George-SK/Smart-Street-Lamp---LORa-Terminal/_document/BaldurMind各频段节点时间同步默认组播地址.docx

# BaldurMind

# 各频段节点时间同步默认组播地址

频段 | 地址 | NwkSKeys | AppSKeys
CN470 | FFFFFFFF | 0691c28cd2861ecbb8b1f53366311530 | 8aed39c164a698924727ced78ee4ead0
EU863 | FFFFFFFE | 0691c28cd2861ecbb8b1f53366311531 | 8aed39c164a698924727ced78ee4ead1
AU915 | FFFFFFFD | 0691c28cd2861ecbb8b1f53366311532 | 8aed39c164a698924727ced78ee4ead2
US902 | FFFFFFFC | 0691c28cd2861ecbb8b1f53366311533 | 8aed39c164a698924727ced78ee4ead3
AS923 | FFFFFFFB | 0691c28cd2861ecbb8b1f53366311534 | 8aed39c164a698924727ced78ee4ead4
