George-SK/Smart-Street-Lamp---LORa-Terminal/hardware/AC灯控板原理图.pdf

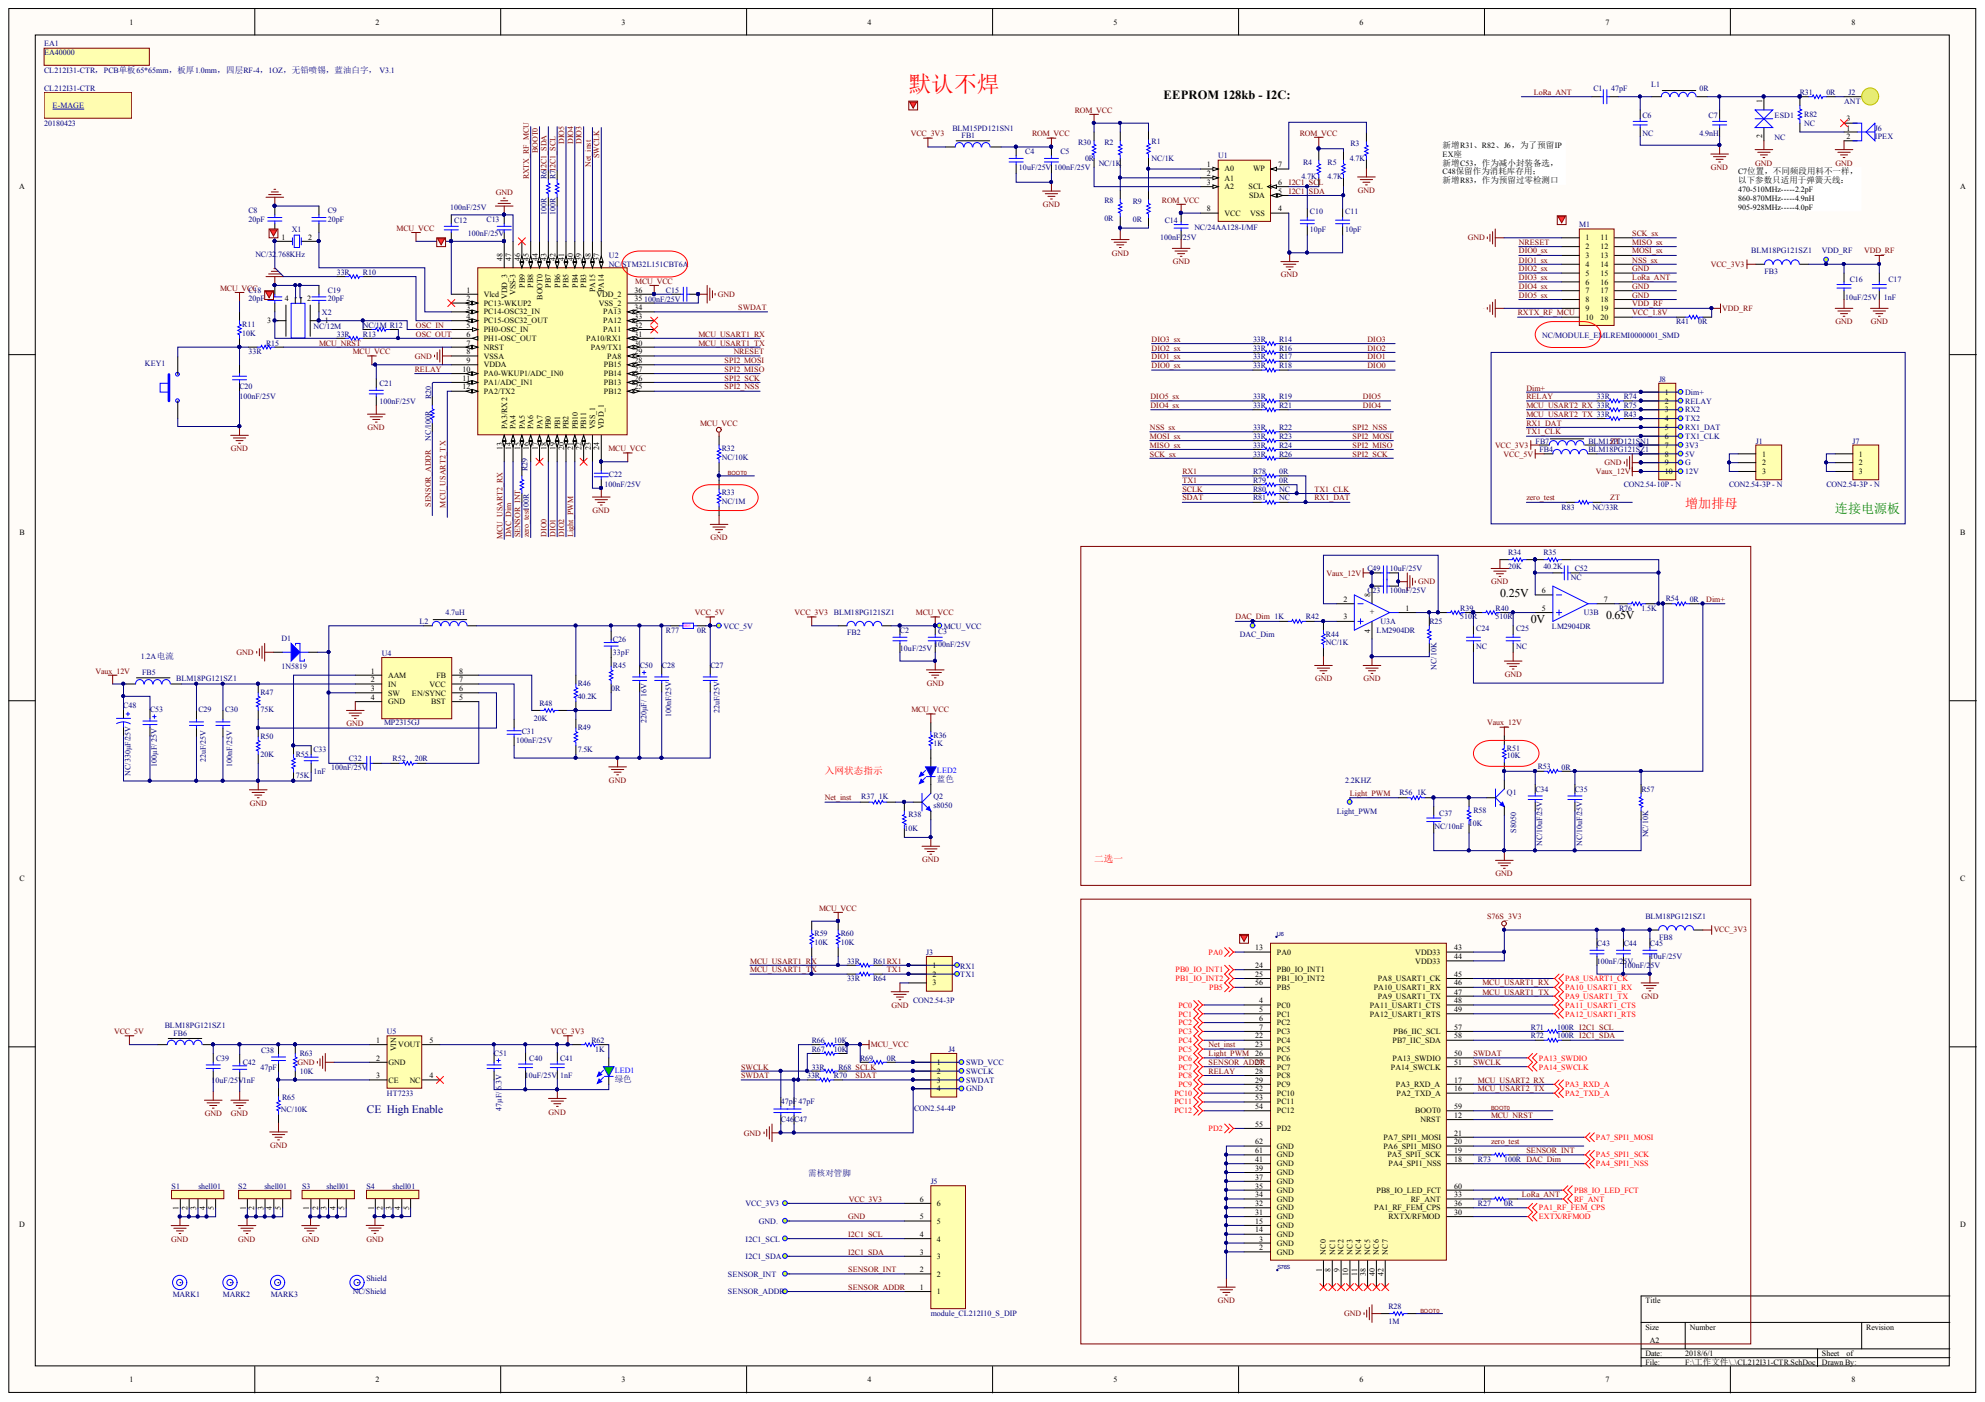
[picture p17: page 1]

CL212I31-CTR，PCB单板65*65mm，板厚1.0mm，四层RF-4，1OZ，无铅喷锡，蓝油白字， V3.1
