George-SK/Smart-Street-Lamp---LORa-Terminal/hardware/AC灯控电源板原理图.pdf

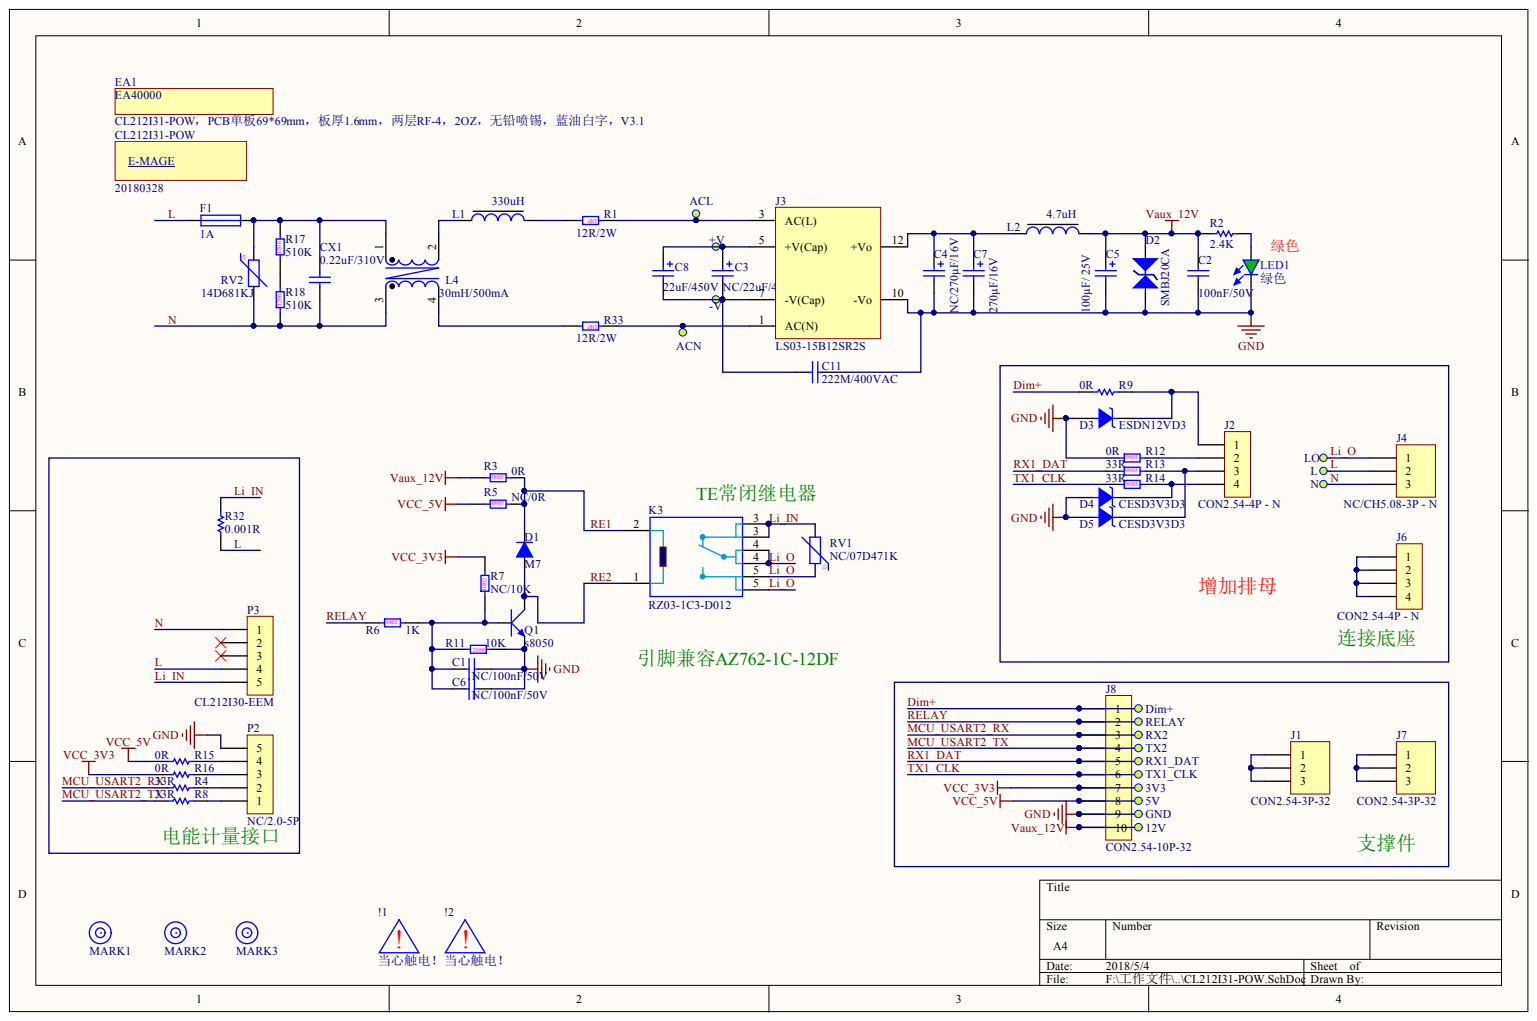
[picture p18: page 1]

CL212I31-POW，PCB单板69*69mm，板厚1.6mm，两层RF-4，2OZ，无铅喷锡，蓝油白字，V3.1
CL212I31-POW
