George-SK/Smart-Street-Lamp---LORa-Terminal/hardware/EMLLC-B-CTR11.pdf

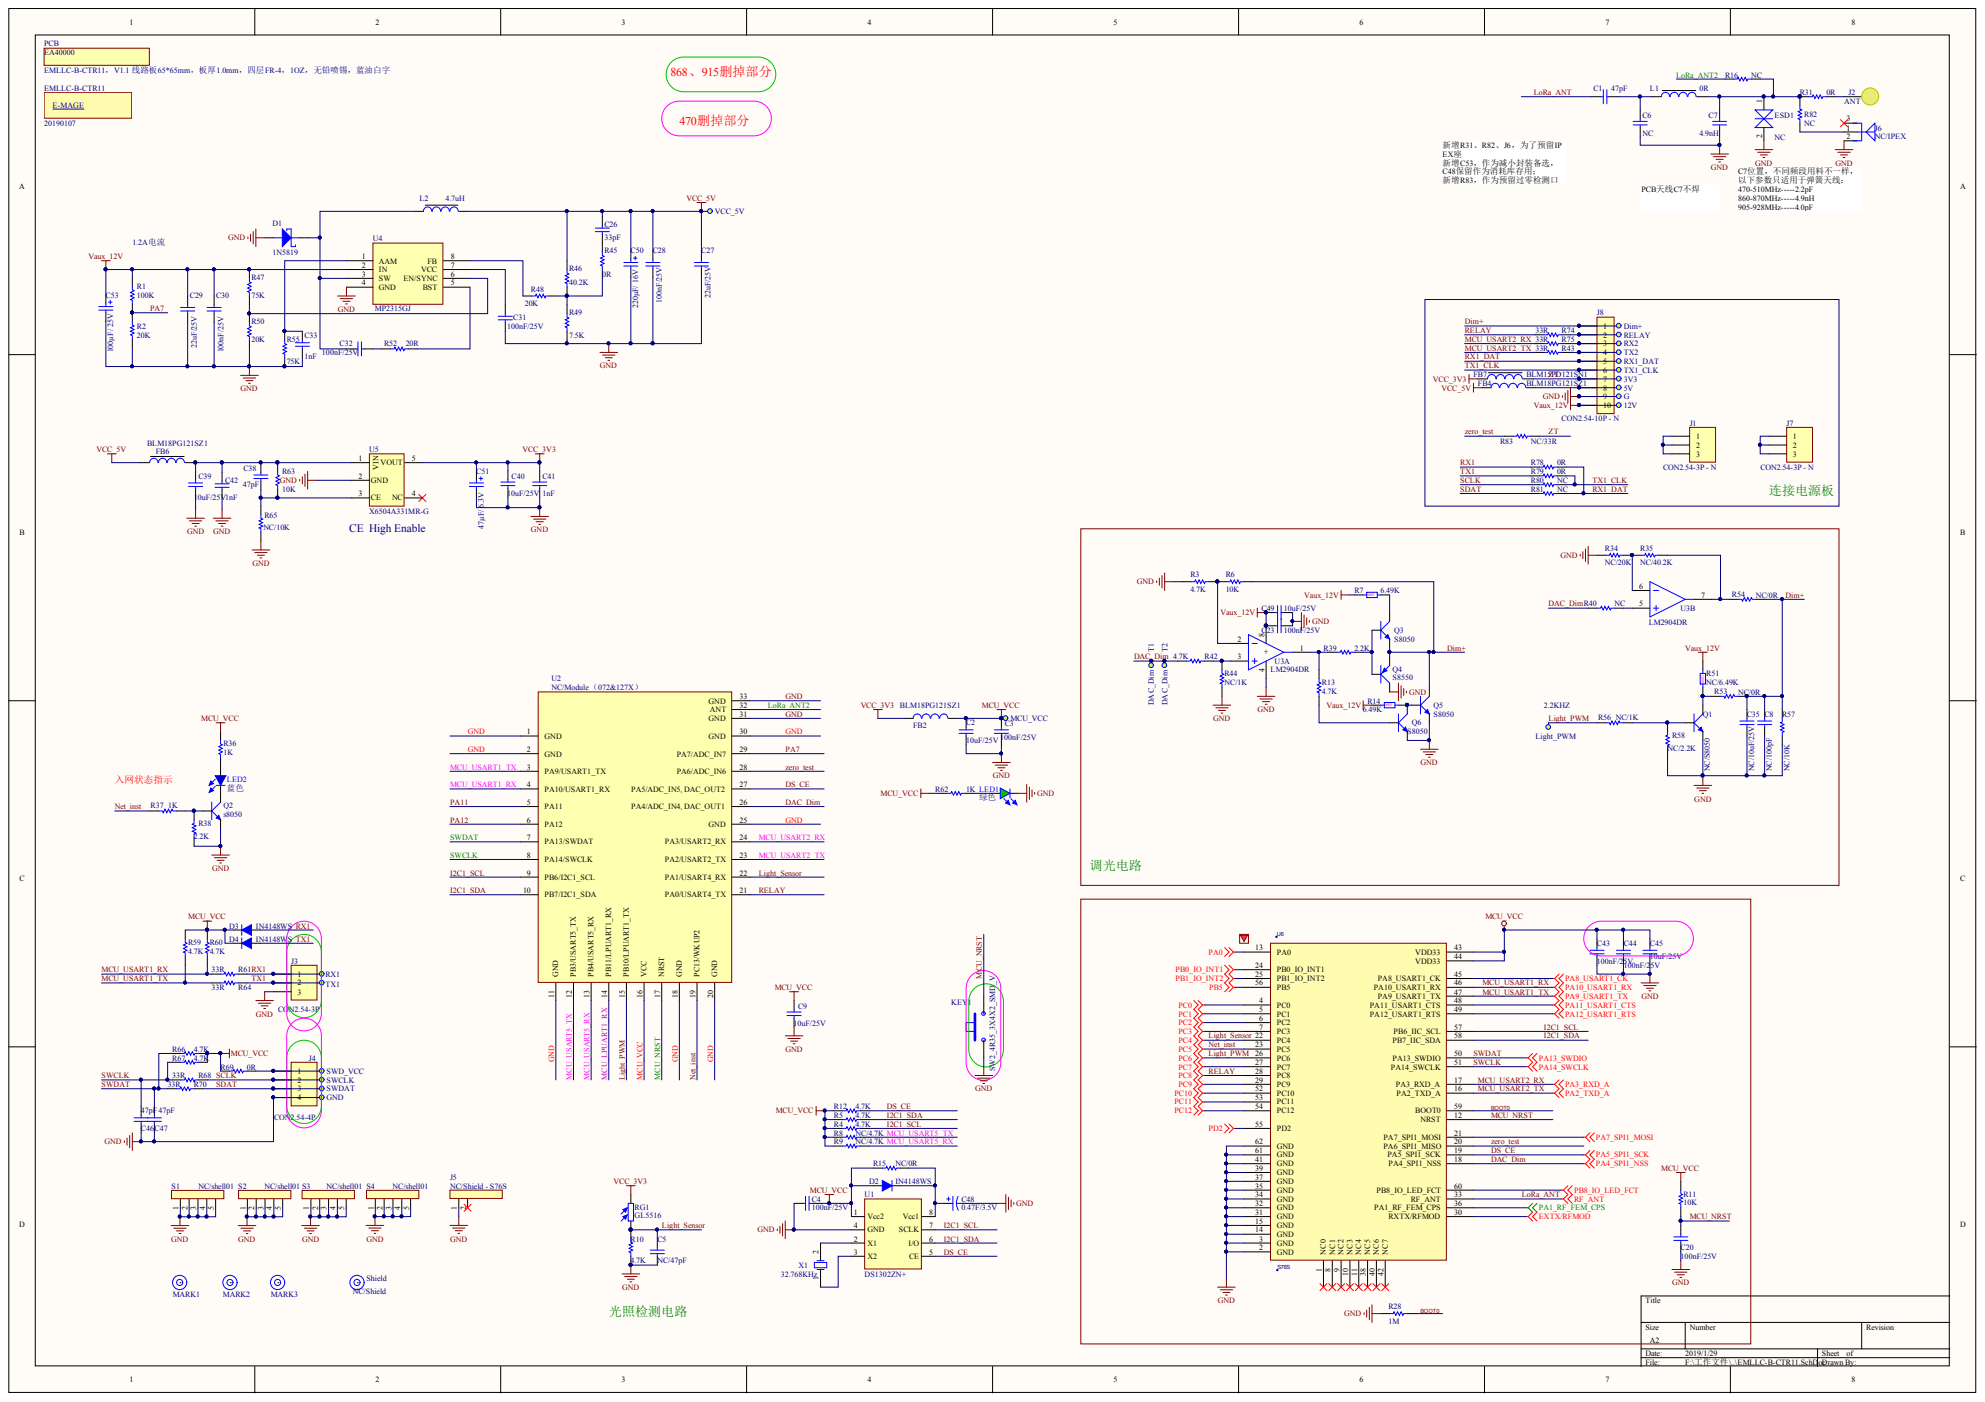
[picture p19: page 1]

EMLLC-B-CTR11，V1.1 线路板65*65mm，板厚1.0mm，四层FR-4，1OZ，无铅喷锡，蓝油白字

AAM 1
IN 2
SW 3
