George-SK/Smart-Street-Lamp---LORa-Terminal/software/ACLight_LoRaMac_Node_20190226/Doc/SensorNode-schematic.pdf

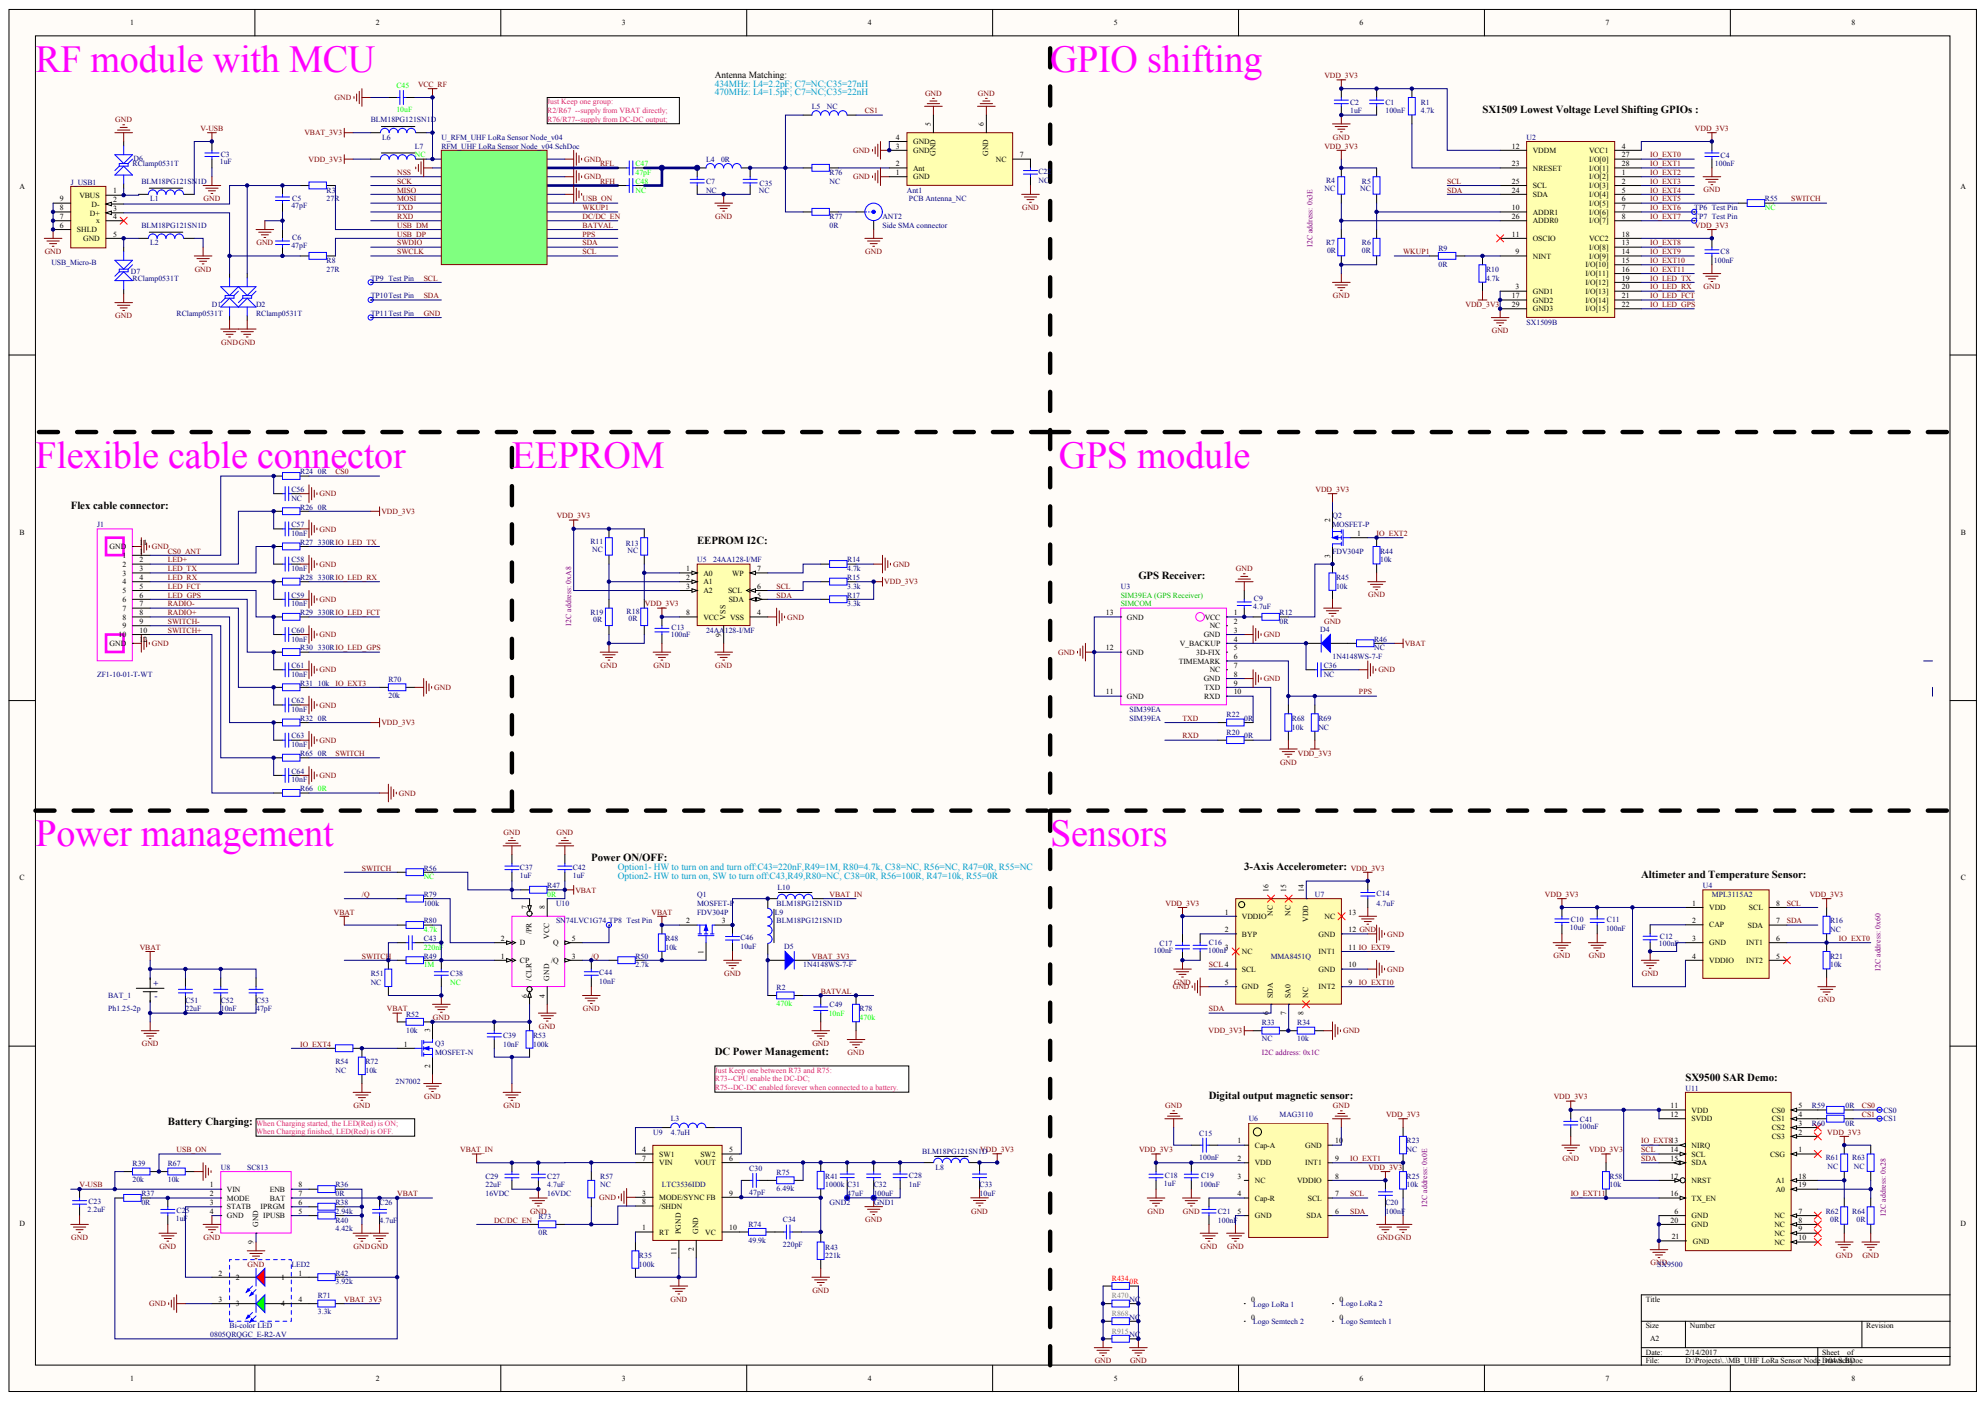
[picture p20: page 1]

RF module with MCU

Antenna Matching: 434MHz: L4=2.2pF; C7=NC;C35=27nH 470MHz: L4=1.5pF; C7=NC;C35=22nH

Just Keep one group:
R2/R67 --supply from VBAT directly;
R76/R77--supply from DC-DC output;

SX1509 Lowest Voltage Level Shifting GPIOs :

Power ON/OFF:
Option2- HW to turn on, SW to turn off:C43,R49,R80=NC, C38=0R, R56=100R, R47=10k, R55=0R Option1- HW to turn on and turn off:C43=220nF,R49=1M, R80=4.7k, C38=NC, R56=NC, R47=0R, R55=NC

Altimeter and Temperature Sensor:

Just Keep one between R73 and R75:
R73--CPU enable the DC-DC;
R75--DC-DC enabled forever when connected to a battery.

Digital output magnetic sensor:

When Charging started, the LED(Red) is ON;
When Charging finished, LED(Red) is OFF.

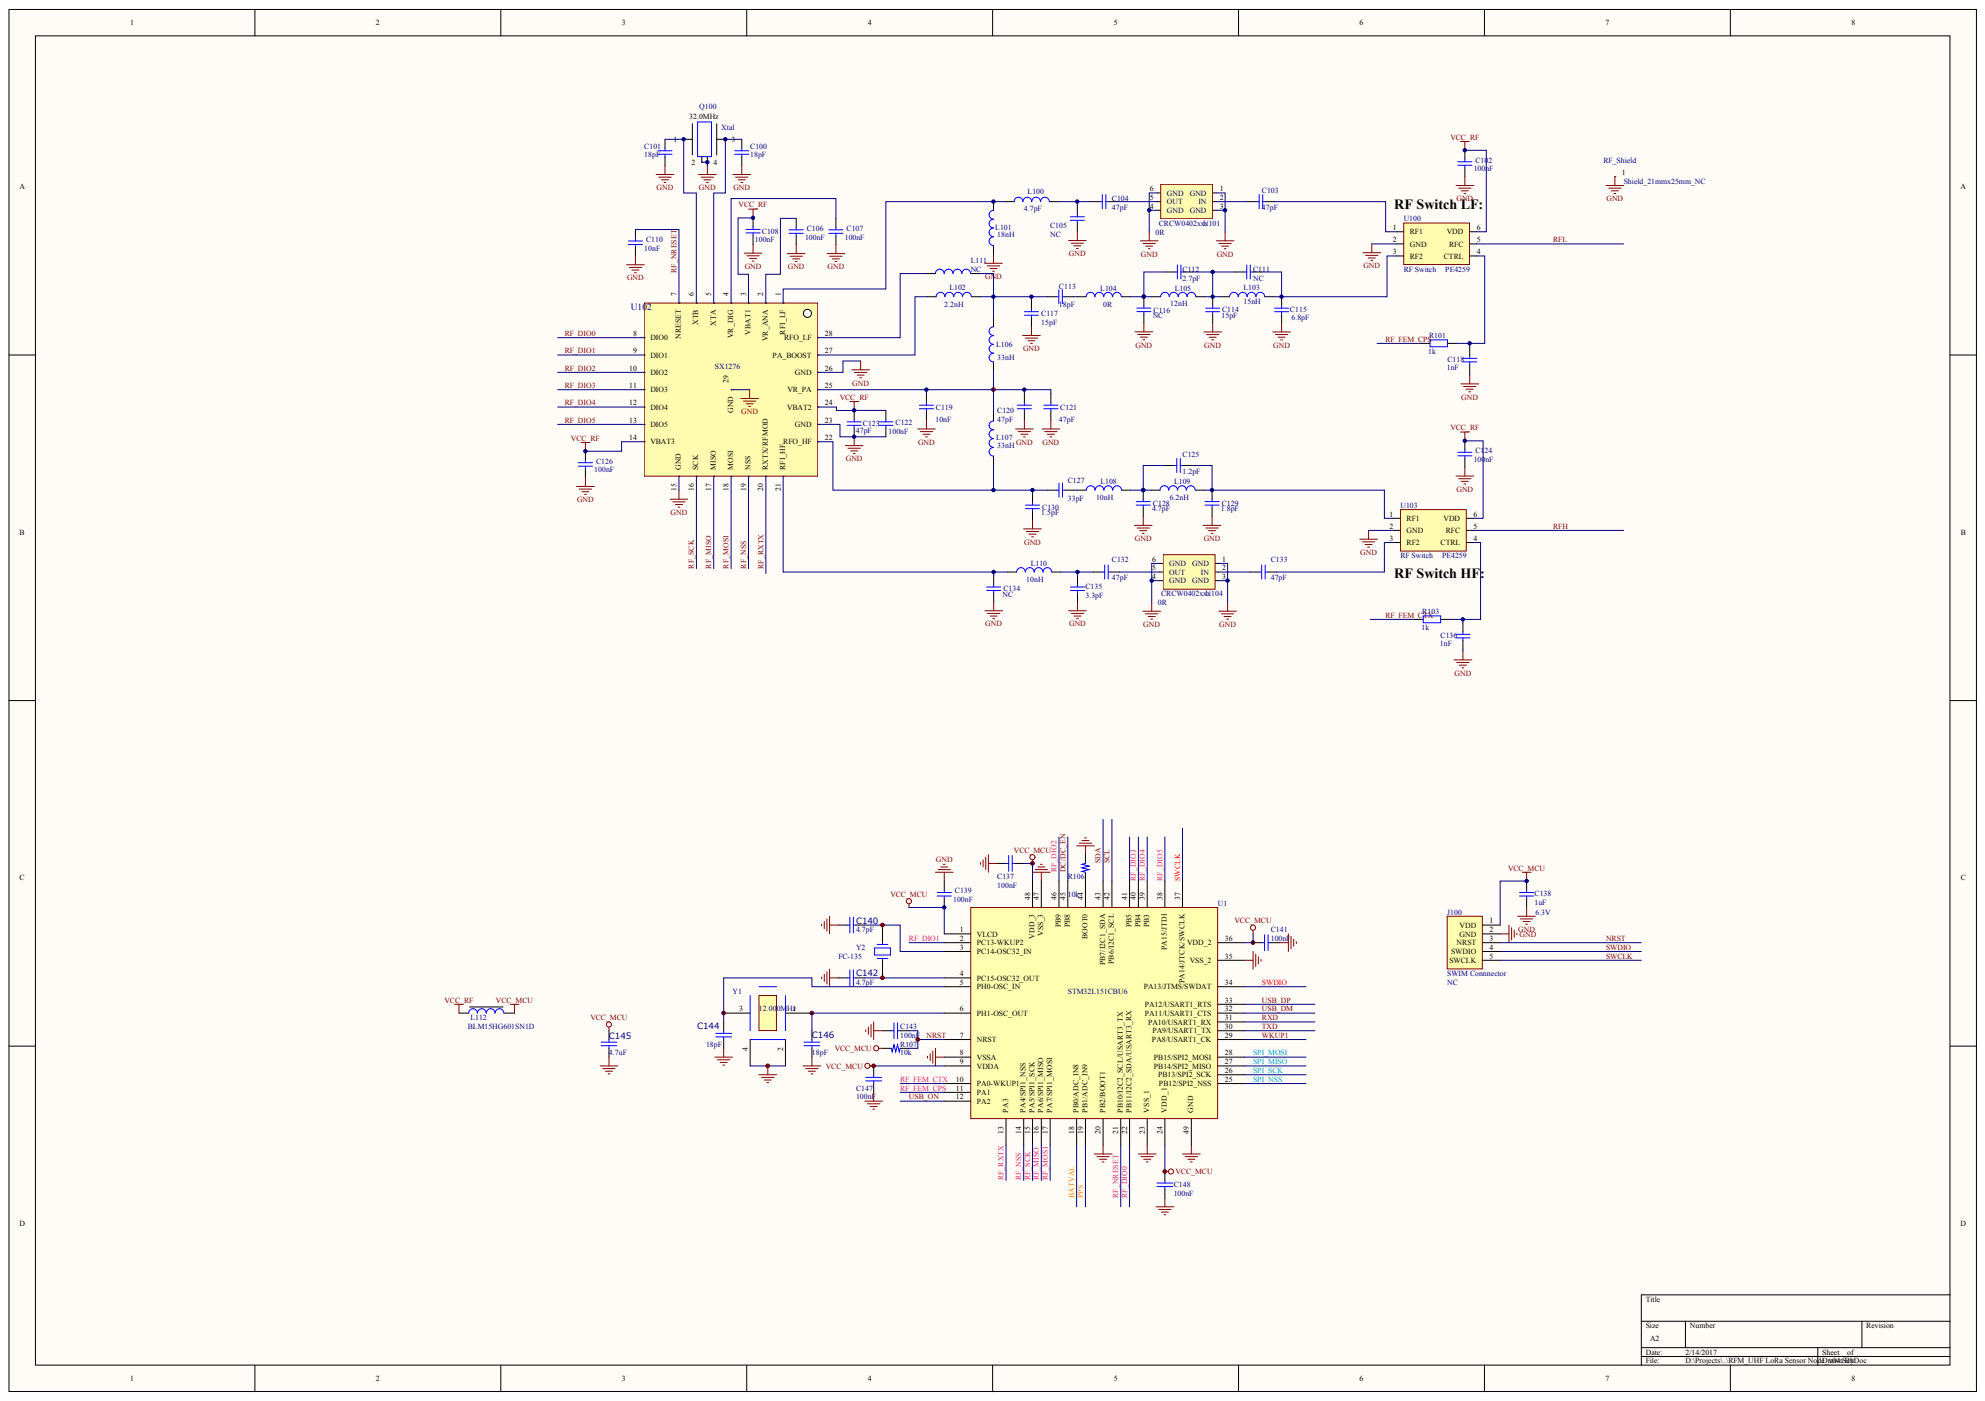
[picture p21: page 2]

Y1 | | | PH0-OSC_IN 5

NRST

NRST 7

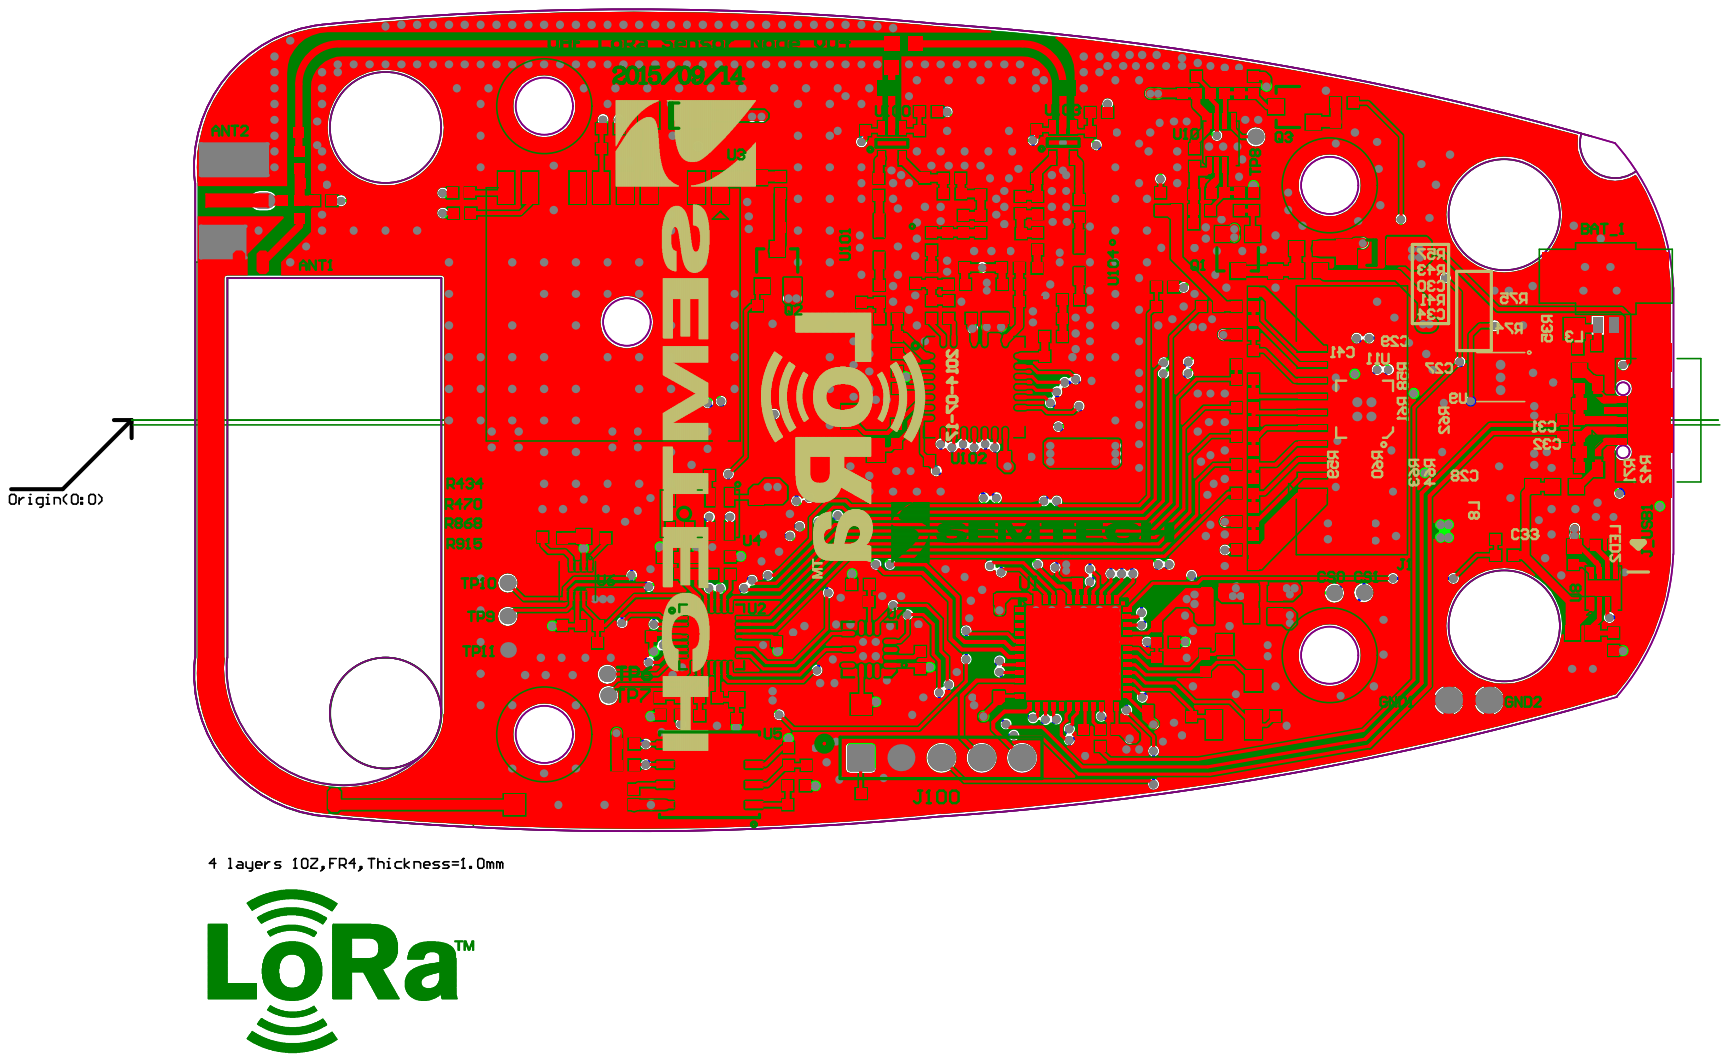
[picture p22: page 3]
