George-SK/Smart-Street-Lamp---LORa-Terminal/_document/FOTA通信协议_20190109.pdf

## 节点固件空中升级通信协议

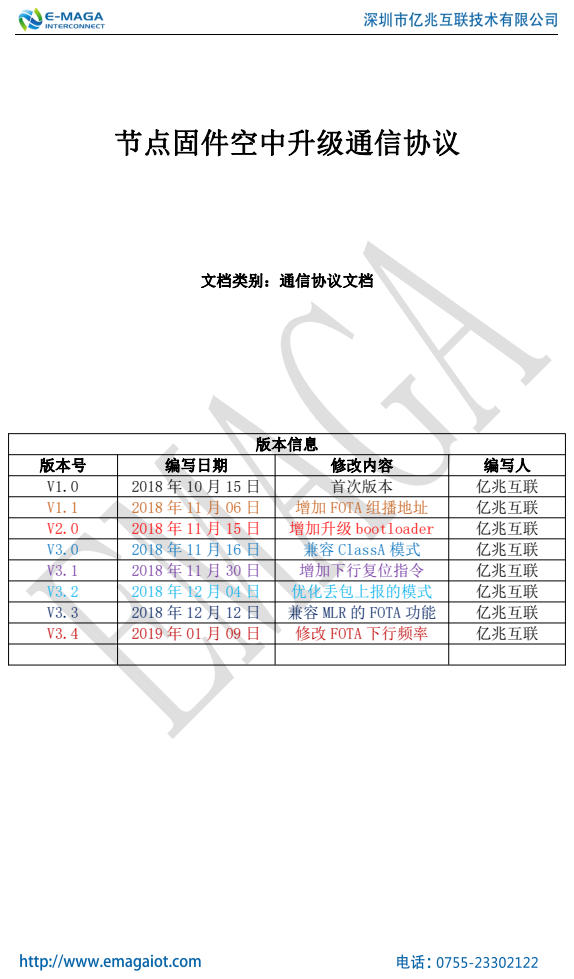
[picture p28: page 1]
文档类别：通信协议文档; 版本信息

版本号 | 编写日期 | 修改内容 | 编写人
V1.0 | 2018 年 10 月 15 日 | 首次版本 | 亿兆互联
V1.1 | 2018 年 11 月 06 日 | 增加 FOTA 组播地址 | 亿兆互联
V2.0 | 2018 年 11 月 15 日 | 增加升级 bootloader | 亿兆互联
V3.0 | 2018 年 11 月 16 日 | 兼容 ClassA 模式 | 亿兆互联
V3.1 | 2018 年 11 月 30 日 | 增加下行复位指令 | 亿兆互联
V3.2 | 2018 年 12 月 04 日 | 优化丢包上报的模式 | 亿兆互联
V3.3 | 2018 年 12 月 12 日 | 兼容 MLR 的 FOTA 功能 | 亿兆互联
V3.4 | 2019 年 01 月 09 日 | 修改 FOTA 下行频率 | 亿兆互联

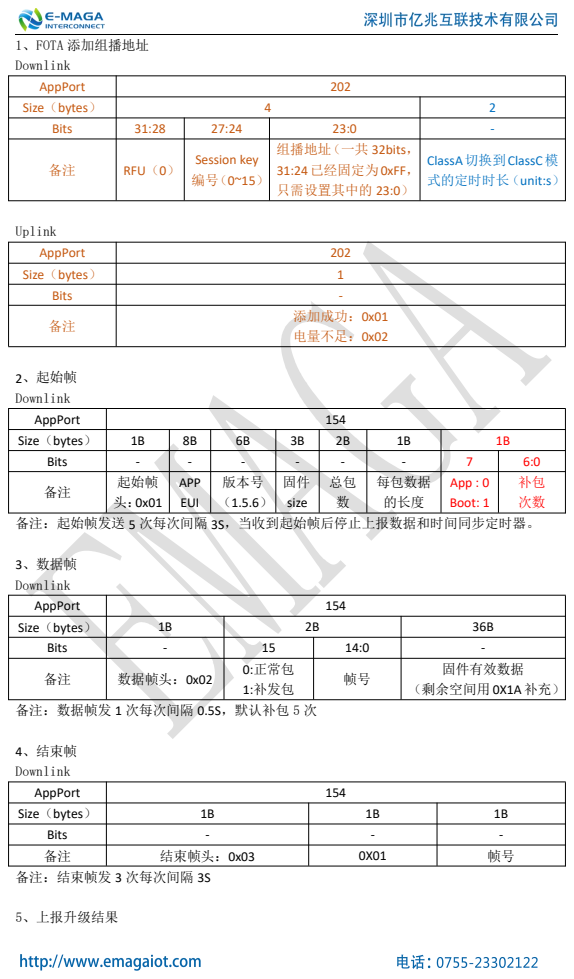
[picture p29: page 2]
1、FOTA 添加组播地址 Downlink; Bits; RFU（0）; Session key; 组播地址（一共 32bits， 31:24已经固定为0xFF， 只需设置其中的 23:0）; ClassA切换到ClassC模 式的定时时长（unit:s）; Uplink; 2、起始帧; Downlink; 3、数据帧; 4、结束帧; 5、上报升级结果

AppPort | 202
Size（bytes） | 4 | 2

Size（bytes） | 1
Bits | - 备注

添加成功：0x01 电量不足：0x02

AppPort | 154
Size（bytes） | 1B | 8B | 6B | 3B | 2B | 1B | 1B
Bits | - | - | - | - | - | - | 7 | 6:0
备注 | 起始帧 头：0x01 | APP EUI | 版本号 （1.5.6） | 固件 size | 总包 数 | 每包数据 的长度 | App : 0 Boot: 1 | 补包 次数

备注：起始帧发送 5 次每次间隔 3S，当收到起始帧后停止上报数据和时间同步定时器。

Size（bytes） | 1B | 2B | 36B
Bits | 数据帧头：0x02 - | 15 | 14:0 | - 备注

0:正常包 1:补发包 | 帧号 | 固件有效数据 （剩余空间用 0X1A 补充）

备注：数据帧发 1 次每次间隔 0.5S，默认补包 5 次

Size（bytes） | 1B | 1B | 1B
Bits | 结束帧头：0x03 - | 0X01 - | 帧号 - 备注

备注：结束帧发 3 次每次间隔 3S

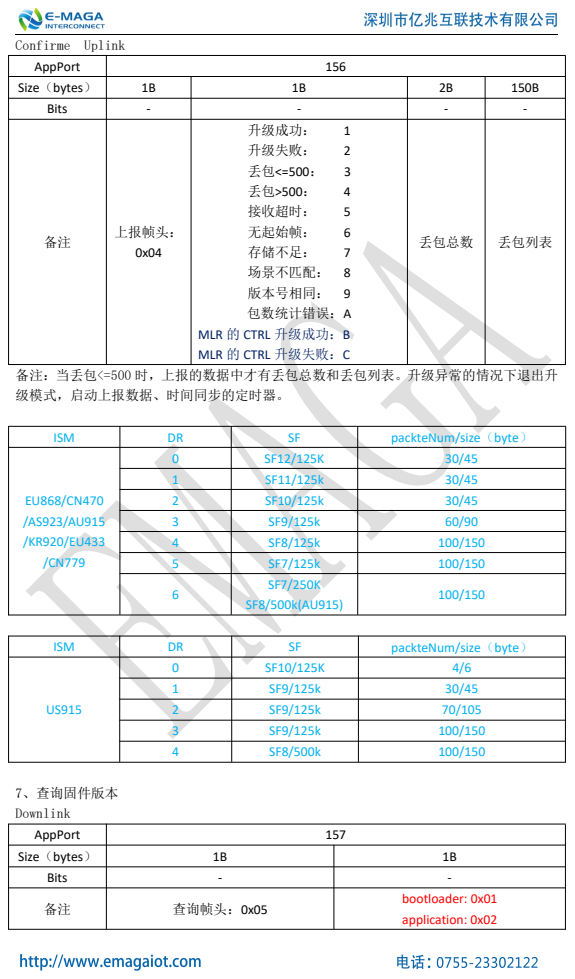
[picture p30: page 3]
Confirme Uplink; Bits; 上报帧头： 0x04; 升级成功：; 升级失败：; 接收超时：; 无起始帧：; 存储不足：; 丢包总数; 丢包列表; 7、查询固件版本 Downlink

AppPort | 156
Size（bytes） | 1B | 1B | 2B | 150B

场景不匹配： 8
版本号相同： 9
包数统计错误：A
MLR 的 CTRL 升级成功：B
MLR 的 CTRL 升级失败：C

备注：当丢包<=500 时，上报的数据中才有丢包总数和丢包列表。升级异常的情况下退出升
级模式，启动上报数据、时间同步的定时器。

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

US915 | 0 | SF10/125K | 4/6

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

AppPort | 157
Size（bytes） | 1B | 1B
Bits | 查询帧头：0x05 - | - 备注

bootloader: 0x01 application: 0x02

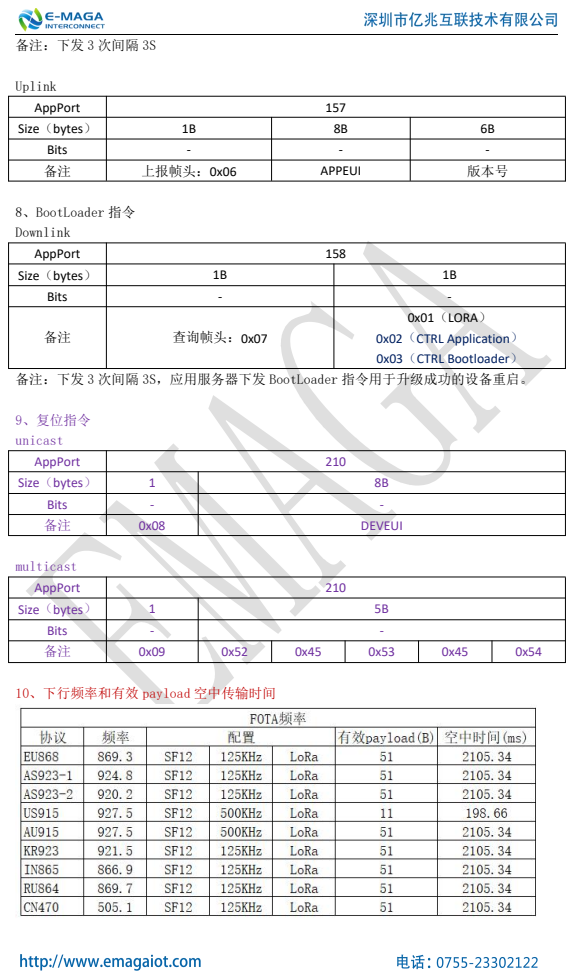
[picture p31: page 4]
Uplink; 8、BootLoader 指令 Downlink; Bits; 查询帧头：0x07; 0x01（LORA） 0x02（CTRL Application） 0x03（CTRL Bootloader）; 9、复位指令 unicast; multicast

备注：下发 3 次间隔 3S

AppPort | 157
Size（bytes） | 1B | 8B | 6B
Bits | 上报帧头：0x06 - | APPEUI - | 版本号 - 备注

AppPort | 158
Size（bytes） | 1B | 1B

备注：下发 3 次间隔 3S，应用服务器下发 BootLoader 指令用于升级成功的设备重启。

AppPort | 210
Size（bytes） | 1 | 8B
Bits | 0x08 - | DEVEUI - 备注

Size（bytes） | 1 | 5B

10、下行频率和有效 payload 空中传输时间
