George-SK/Smart-Street-Lamp---LORa-Terminal/software/ACLight_LoRaMac_Node_20190226/src/boards/EmdoorNode/STM32L0/board.c

/*
  ______                              _
 / _____)             _              | |
( (____  _____ ____ _| |_ _____  ____| |__
 \____ \| ___ |    (_   _) ___ |/ ___)  _ \
 _____) ) ____| | | || |_| ____( (___| | | |
(______/|_____)_|_|_| \__)_____)\____)_| |_|
    (C)2013 Semtech

Description: Target board general functions implementation

License: Revised BSD License, see LICENSE.TXT file include in the project

Maintainer: Miguel Luis and Gregory Cristian
*/
#include "board.h"
#include "upgrad.h"
#include "test.h"

/*!
 * Unique Devices IDs register set ( STM32L1xxx )
 */
#define         ID1                                 ( 0x1FF80050 )
#define         ID2                                 ( 0x1FF80054 )
#define         ID3                                 ( 0x1FF80064 )

/*!
 * LED GPIO pins objects
 */
//Gpio_t Led1;
//Gpio_t Led2;

/*!
 * UART macro and variables definition
 */
#define FIFO_RX_SIZE                                200//128	//Modified by Steven in 2018/01/25.
uint8_t UARTRxBuffer[FIFO_RX_SIZE];

uint8_t AppString[FIFO_RX_SIZE];
uint8_t AppStringSize = 0;
uint8_t RecvFlag = 0, StartFlag = 0;

/*
 * MCU objects
 */
Adc_t Adc;
Uart_t Uart1;
I2c_t I2c;

/*!
 * Initializes the unused GPIO to a know status
 */
static void BoardUnusedIoInit( void );

/*!
 * System Clock Configuration
 */
static void SystemClockConfig( void );

#ifndef LORA_WITH_OS_PWR_MGMT

/*!
 * Used to measure and calibrate the system wake-up time from STOP mode
 */
static void CalibrateSystemWakeupTime( void );

#endif /* LORA_WITH_OS_PWR_MGMT */

/*!
 * System Clock Re-Configuration when waking up from STOP mode
 */
void SystemClockReConfig( void );

#ifndef LORA_WITH_OS_PWR_MGMT

/*!
 * Timer used at first boot to calibrate the SystemWakeupTime
 */
static TimerEvent_t CalibrateSystemWakeupTimeTimer;

#endif /* LORA_WITH_OS_PWR_MGMT */

/*!
 * Flag to indicate if the MCU is Initialized
 */
static bool McuInitialized = false;

/*!
 * Flag used to indicate if board is powered from the USB
 */
static bool UsbIsConnected = false;

#ifndef LORA_WITH_OS_PWR_MGMT

/*!
 * Flag to indicate if the SystemWakeupTime is Calibrated
 */
static bool SystemWakeupTimeCalibrated = false;

#endif /* !LORA_WITH_OS_PWR_MGMT */

/*!
 * Flag to indicate the Status of LED3
 */
volatile uint8_t Led3Status = 1;

#ifndef LORA_WITH_OS_PWR_MGMT

/*!
 * Callback indicating the end of the system wake-up time calibration
 */
static void OnCalibrateSystemWakeupTimeTimerEvent( void )
{
    SystemWakeupTimeCalibrated = true;
}

#endif /* LORA_WITH_OS_PWR_MGMT */

/*!
 * Nested interrupt counter.
 *
 * \remark Interrupt should only be fully disabled once the value is 0
 */


static uint8_t IrqNestLevel = 0;

void BoardDisableIrq( void )
{
    __disable_irq( );
    IrqNestLevel++;
}

void BoardEnableIrq( void )
{
    IrqNestLevel--;
    if( IrqNestLevel == 0 )
    {
        __enable_irq( );
    }
}

void BoardInitPeriph( void )
{   
	StreetLightInit();
	QueueInit();
	Rn820xInit();
	ProfileInit();
#if defined (GL5516_PHOTOREISTANCE_ENABLE)
	GL5516_init();
#endif
}

void UartTimeoutHandler(void)
{
	static uint32_t currentTime = 0, contextTime = 0;
	uint32_t timeOutValue = 0;
	
	if(StartFlag)
	{
		currentTime = RtcGetTimerValue();
	
		if(RecvFlag)
		{
			contextTime = currentTime;
			RecvFlag = 0;
		}
		
		if( currentTime < contextTime )
		{
			timeOutValue = currentTime + ( 0xFFFFFFFF - contextTime );
		}
		else
		{
			timeOutValue = currentTime - contextTime;
		}
		
		if( timeOutValue > 10 )	//Timeout;
		{
			contextTime = currentTime;
			
			if( AppStringSize > 0 )
			{
					UpgradeProgram(AppString, AppStringSize);       //George@20180607:IAP
					if (AutoTestMode_flag == true)
					{
						ProductionTestMode(AppString, AppStringSize); //George@20180614:test mode
					}
					else if (ATcommend_flag == false)
					{
						CelibrateHandler(AppString, AppStringSize);
					}
					ATcommend_flag = false;
					memset(AppString, 0, FIFO_RX_SIZE);             //George@20180622:clear array
					AppStringSize = 0;
			}
			
			StartFlag = 0;
		}
	}	
}

void loraMcuIrqNotify( UartNotifyId_t id )
{
    uint8_t data;
    if( id == UART_NOTIFY_RX )
    {
        if( UartGetChar( &Uart1, &data ) == 0 )
        {
            if( AppStringSize < FIFO_RX_SIZE )
            {
                AppString[AppStringSize++] = data;
							
								RecvFlag = 1;
											
								if(AppStringSize == 1)
									StartFlag = 1;
            }  
            else
                AppStringSize=0; 
        }
    }  
}

/*!
 * UART FIFO buffers size
 */
#define UART_FIFO_TX_SIZE                                256
#define UART_FIFO_RX_SIZE                                256

uint8_t UartTxBuffer[UART_FIFO_TX_SIZE];
uint8_t UartRxBuffer[UART_FIFO_RX_SIZE];

void BoardInitMcu( void )
{
    //Gpio_t ioPin;

    if( McuInitialized == false )
    {
        HAL_Init( );

        SystemClockConfig( );

        UsbIsConnected = true;
        FifoInit( &Uart1.FifoTx, UartTxBuffer, UART_FIFO_TX_SIZE );
        FifoInit( &Uart1.FifoRx, UartRxBuffer, UART_FIFO_RX_SIZE );
        FifoInit( &Uart1.FifoRx, UARTRxBuffer, FIFO_RX_SIZE ); 
        Uart1.IrqNotify = loraMcuIrqNotify;
        UartInit( &Uart1, UART_1, UART_TX, UART_RX );
        UartConfig( &Uart1, RX_TX, 115200, UART_8_BIT, UART_1_STOP_BIT, NO_PARITY, NO_FLOW_CTRL );
					
        //sk@20180615:Printf log 
        Uart1.PrintfLog = printf; 
        Uart1.PrintfTestLog = printf;
				//end

        RtcInit( );

        BoardUnusedIoInit( );
    }
    else
    {
        SystemClockReConfig( );
    }

    I2cInit( &I2c, I2C1_SCL, I2C1_SDA );
    AdcInit( &Adc, BAT_LEVEL_PIN );

    SpiInit( &SX1276.Spi, RADIO_MOSI, RADIO_MISO, RADIO_SCLK, NC );
    SX1276IoInit( );

    if( McuInitialized == false )
    {
        McuInitialized = true;

#ifndef LORA_WITH_OS_PWR_MGMT

        /* this code do something looks not in need */

        if( GetBoardPowerSource( ) == BATTERY_POWER )
        {
            //CalibrateSystemWakeupTime( );	//Modified by Steven in 2018/07/18.
        }

#endif /* LORA_WITH_OS_PWR_MGMT */
    }
}

void BoardDeInitMcu( void )
{
    ////I2cDeInit( &I2c );
    AdcDeInit( &Adc );

    SpiDeInit( &SX1276.Spi );
    SX1276IoDeInit( );
}

uint32_t BoardGetRandomSeed( void )
{
    return ( ( *( uint32_t* )ID1 ) ^ ( *( uint32_t* )ID2 ) ^ ( *( uint32_t* )ID3 ) );
}

void BoardGetUniqueId( uint8_t *id )
{
    id[7] = ( ( *( uint32_t* )ID1 )+ ( *( uint32_t* )ID3 ) ) >> 24;
    id[6] = ( ( *( uint32_t* )ID1 )+ ( *( uint32_t* )ID3 ) ) >> 16;
    id[5] = ( ( *( uint32_t* )ID1 )+ ( *( uint32_t* )ID3 ) ) >> 8;
    id[4] = ( ( *( uint32_t* )ID1 )+ ( *( uint32_t* )ID3 ) );
    id[3] = ( ( *( uint32_t* )ID2 ) ) >> 24;
    id[2] = ( ( *( uint32_t* )ID2 ) ) >> 16;
    id[1] = ( ( *( uint32_t* )ID2 ) ) >> 8;
    id[0] = ( ( *( uint32_t* )ID2 ) );
}

/*!
 * Factory power supply
 */
#define FACTORY_POWER_SUPPLY                        3300 // mV

/*!
 * VREF calibration value
 */
#define VREFINT_CAL                                 ( *( uint16_t* )0x1FF80078 )

/*!
 * ADC maximum value
 */
#define ADC_MAX_VALUE                               4095

/*!
 * Battery thresholds
 */
#define BATTERY_MAX_LEVEL                           4500 // mV
#define BATTERY_MIN_LEVEL                           1800 // mV
#define BATTERY_SHUTDOWN_LEVEL                      1900 // mV

static uint16_t BatteryVoltage = BATTERY_MAX_LEVEL;

uint16_t BoardBatteryMeasureVolage( void )
{
    uint16_t vdd = 0;
    uint16_t vref = VREFINT_CAL;
    uint16_t vdiv = 0;
    uint16_t batteryVoltage = 0;

    vdiv = AdcReadChannel( &Adc, BAT_LEVEL_CHANNEL );
    //vref = AdcReadChannel( &Adc, ADC_CHANNEL_VREFINT );

    vdd = ( float )FACTORY_POWER_SUPPLY * ( float )VREFINT_CAL / ( float )vref;
    batteryVoltage = vdd * ( ( float )vdiv / ( float )ADC_MAX_VALUE );

    //                                vDiv
    // Divider bridge  VBAT <-> 47k -<--|-->- 47k <-> GND => vBat = 2 * vDiv
    batteryVoltage = 2 * batteryVoltage;
    return batteryVoltage;
}

uint32_t BoardGetBatteryVoltage( void )
{
    return BatteryVoltage;
}

uint8_t BoardGetBatteryLevel( void )
{
    uint8_t batteryLevel = 0;

    BatteryVoltage = BoardBatteryMeasureVolage( );

#if !defined( USE_BAT_DBG )
    if( GetBoardPowerSource( ) == USB_POWER )
    {
        batteryLevel = 0;
    }
    else
#endif
    {
        if( BatteryVoltage >= BATTERY_MAX_LEVEL )
        {
            batteryLevel = 254;
        }
        else if( ( BatteryVoltage > BATTERY_MIN_LEVEL ) && ( BatteryVoltage < BATTERY_MAX_LEVEL ) )
        {
            batteryLevel = ( ( 253 * ( BatteryVoltage - BATTERY_MIN_LEVEL ) ) / ( BATTERY_MAX_LEVEL - BATTERY_MIN_LEVEL ) ) + 1;
        }
        else if( ( BatteryVoltage > BATTERY_SHUTDOWN_LEVEL ) && ( BatteryVoltage <= BATTERY_MIN_LEVEL ) )
        {
            batteryLevel = 1;
        }
        else //if( BatteryVoltage <= BATTERY_SHUTDOWN_LEVEL )
        {
            batteryLevel = 255;
        }
    }
    return batteryLevel;
}

static void BoardUnusedIoInit( void )
{
    //Gpio_t ioPin;

    if( GetBoardPowerSource( ) == USB_POWER )
    {
        HAL_DBGMCU_EnableDBGSleepMode( );
        HAL_DBGMCU_EnableDBGStopMode( );
        HAL_DBGMCU_EnableDBGStandbyMode( );
    }
    else
    {
        HAL_DBGMCU_DisableDBGSleepMode( );
        HAL_DBGMCU_DisableDBGStopMode( );
        HAL_DBGMCU_DisableDBGStandbyMode( );
//        GpioInit( &ioPin, SWCLK, PIN_ANALOGIC, PIN_PUSH_PULL, PIN_NO_PULL, 1 );
//        GpioInit( &ioPin, SWDAT, PIN_ANALOGIC, PIN_PUSH_PULL, PIN_NO_PULL, 1 );
//        GpioInit( &ioPin, UART_TX, PIN_ANALOGIC, PIN_PUSH_PULL, PIN_NO_PULL, 0 );
//        GpioInit( &ioPin, UART_RX, PIN_ANALOGIC, PIN_PUSH_PULL, PIN_NO_PULL, 0 );
    }
}

void SystemClockConfig( void )
{
	RCC_OscInitTypeDef RCC_OscInitStruct;
	RCC_ClkInitTypeDef RCC_ClkInitStruct;
	RCC_PeriphCLKInitTypeDef PeriphClkInit;

	__HAL_RCC_PWR_CLK_ENABLE();

	__HAL_PWR_VOLTAGESCALING_CONFIG(PWR_REGULATOR_VOLTAGE_SCALE1);

	RCC_OscInitStruct.OscillatorType = RCC_OSCILLATORTYPE_HSE|RCC_OSCILLATORTYPE_LSE;
	RCC_OscInitStruct.HSEState = RCC_HSE_ON;
	RCC_OscInitStruct.LSEState = RCC_LSE_ON;
	RCC_OscInitStruct.PLL.PLLState = RCC_PLL_ON;
	RCC_OscInitStruct.PLL.PLLSource = RCC_PLLSOURCE_HSE;
#if defined (STM32L073xx)
	RCC_OscInitStruct.PLL.PLLMUL = RCC_PLLMUL_4;
#elif defined (STM32L072xx)
	RCC_OscInitStruct.PLL.PLLMUL = RCC_PLLMUL_8;
#endif
	RCC_OscInitStruct.PLL.PLLDIV = RCC_PLLDIV_3;
	if (HAL_RCC_OscConfig(&RCC_OscInitStruct) != HAL_OK)
	{
		assert_param( FAIL );
	}

	RCC_ClkInitStruct.ClockType = RCC_CLOCKTYPE_HCLK|RCC_CLOCKTYPE_SYSCLK
							  |RCC_CLOCKTYPE_PCLK1|RCC_CLOCKTYPE_PCLK2;
	RCC_ClkInitStruct.SYSCLKSource = RCC_SYSCLKSOURCE_PLLCLK;
	RCC_ClkInitStruct.AHBCLKDivider = RCC_SYSCLK_DIV1;
	RCC_ClkInitStruct.APB1CLKDivider = RCC_HCLK_DIV1;
	RCC_ClkInitStruct.APB2CLKDivider = RCC_HCLK_DIV1;
	if (HAL_RCC_ClockConfig(&RCC_ClkInitStruct, FLASH_LATENCY_1) != HAL_OK)
	{
		assert_param( FAIL );
	}

	PeriphClkInit.PeriphClockSelection = RCC_PERIPHCLK_RTC;
	PeriphClkInit.Lpuart1ClockSelection = RCC_LPUART1CLKSOURCE_PCLK1;
	PeriphClkInit.RTCClockSelection = RCC_RTCCLKSOURCE_LSE;
	if (HAL_RCCEx_PeriphCLKConfig(&PeriphClkInit) != HAL_OK)
	{
		assert_param( FAIL );
	}

	HAL_SYSTICK_Config(HAL_RCC_GetHCLKFreq()/1000);	//Modified by Steven. Maybe:1000.

	HAL_SYSTICK_CLKSourceConfig(SYSTICK_CLKSOURCE_HCLK);

	/* SysTick_IRQn interrupt configuration */
	HAL_NVIC_SetPriority(SysTick_IRQn, 0, 1);

}

#ifndef LORA_WITH_OS_PWR_MGMT

void CalibrateSystemWakeupTime( void )
{
    if( SystemWakeupTimeCalibrated == false )
    {
        TimerInit( &CalibrateSystemWakeupTimeTimer, OnCalibrateSystemWakeupTimeTimerEvent );
        TimerSetValue( &CalibrateSystemWakeupTimeTimer, 1000 );
        TimerStart( &CalibrateSystemWakeupTimeTimer );
        while( SystemWakeupTimeCalibrated == false )
        {
            TimerLowPowerHandler( );
        }
    }
}

#endif /* !LORA_WITH_OS_PWR_MGMT */

void SystemClockReConfig( void )
{
    __HAL_RCC_PWR_CLK_ENABLE( );
    __HAL_PWR_VOLTAGESCALING_CONFIG( PWR_REGULATOR_VOLTAGE_SCALE1 );

    /* Enable HSE */
    __HAL_RCC_HSE_CONFIG( RCC_HSE_ON );

    /* Wait till HSE is ready */
    while( __HAL_RCC_GET_FLAG( RCC_FLAG_HSERDY ) == RESET )
    {
    }

    /* Enable PLL */
    __HAL_RCC_PLL_ENABLE( );

    /* Wait till PLL is ready */
    while( __HAL_RCC_GET_FLAG( RCC_FLAG_PLLRDY ) == RESET )
    {
    }

    /* Select PLL as system clock source */
    __HAL_RCC_SYSCLK_CONFIG ( RCC_SYSCLKSOURCE_PLLCLK );

    /* Wait till PLL is used as system clock source */
    while( __HAL_RCC_GET_SYSCLK_SOURCE( ) != RCC_SYSCLKSOURCE_STATUS_PLLCLK )
    {
    }
}

void SysTick_Handler( void )
{
    HAL_IncTick( );
    HAL_SYSTICK_IRQHandler( );

    /*krhino_intrpt_enter();	//Commented by Steven in 2018/03/21.
    
    krhino_tick_proc();
    
    krhino_intrpt_exit();*/
}

uint8_t GetBoardPowerSource( void )
{
    if( UsbIsConnected == false )
    {
        return BATTERY_POWER;
    }
    else
    {
        return USB_POWER;
    }
}

#ifdef USE_FULL_ASSERT
/*
 * Function Name  : assert_failed
 * Description    : Reports the name of the source file and the source line number
 *                  where the assert_param error has occurred.
 * Input          : - file: pointer to the source file name
 *                  - line: assert_param error line source number
 * Output         : None
 * Return         : None
 */
void assert_failed( uint8_t* file, uint32_t line )
{
    /* User can add his own implementation to report the file name and line number,
     ex: printf("Wrong parameters value: file %s on line %d\r\n", file, line) */

    printf( "Wrong parameters value: file %s on line %d\r\n", file, line );
    /* Infinite loop */
    while( 1 )
    {
    }
}
#endif
