George-SK/Smart-Street-Lamp---LORa-Terminal/software/ACLight_LoRaMac_Node_20190226/src/boards/EmdoorNode/STM32L0/adc-board.c

/*
  ______                              _
 / _____)             _              | |
( (____  _____ ____ _| |_ _____  ____| |__
 \____ \| ___ |    (_   _) ___ |/ ___)  _ \
 _____) ) ____| | | || |_| ____( (___| | | |
(______/|_____)_|_|_| \__)_____)\____)_| |_|
    (C)2016 Semtech

Description: Board ADC driver implementation

License: Revised BSD License, see LICENSE.TXT file include in the project

Maintainer: Miguel Luis and Gregory Cristian
*/
#include "board.h"
#include "adc-board.h"

ADC_HandleTypeDef AdcHandle;

void AdcMcuInit( Adc_t *obj, PinNames adcInput )
{
    AdcHandle.Instance = ( ADC_TypeDef* )ADC1_BASE;

    __HAL_RCC_ADC1_CLK_ENABLE( );

    HAL_ADC_DeInit( &AdcHandle );

    if( adcInput != NC )
    {
        GpioInit( &obj->AdcInput, adcInput, PIN_ANALOGIC, PIN_PUSH_PULL, PIN_NO_PULL, 0 );
    }
}

void AdcMcuConfig( void )
{
    // Configure ADC
    AdcHandle.Init.OversamplingMode      = DISABLE;
    AdcHandle.Init.ClockPrescaler        = ADC_CLOCK_SYNC_PCLK_DIV1;
    AdcHandle.Init.Resolution            = ADC_RESOLUTION_12B;
    AdcHandle.Init.SamplingTime          = ADC_SAMPLETIME_239CYCLES_5;//ADC_SAMPLETIME_160CYCLES_5;  /* ADC_SAMPLETIME_239CYCLES_5; The origin driver is too old */	//Modified by Steven for using origin driver.
    AdcHandle.Init.ScanConvMode          = ADC_SCAN_DIRECTION_FORWARD;
    AdcHandle.Init.DataAlign             = ADC_DATAALIGN_RIGHT;
    AdcHandle.Init.ContinuousConvMode    = DISABLE;
    AdcHandle.Init.DiscontinuousConvMode = DISABLE;
    AdcHandle.Init.ExternalTrigConvEdge  = ADC_EXTERNALTRIGCONVEDGE_NONE;
    AdcHandle.Init.ExternalTrigConv      = ADC_EXTERNALTRIGCONV_T6_TRGO;
    AdcHandle.Init.DMAContinuousRequests = DISABLE;
    AdcHandle.Init.EOCSelection          = ADC_EOC_SINGLE_CONV;
    AdcHandle.Init.Overrun               = ADC_OVR_DATA_OVERWRITTEN;
    AdcHandle.Init.LowPowerAutoWait      = DISABLE;
    AdcHandle.Init.LowPowerFrequencyMode = DISABLE; // To be enabled only if ADC clock < 2.8 MHz
    AdcHandle.Init.LowPowerAutoPowerOff  = DISABLE;
    HAL_ADC_Init( &AdcHandle );

    // Calibration
    HAL_ADCEx_Calibration_Start( &AdcHandle, ADC_SINGLE_ENDED );

}

uint16_t AdcMcuReadChannel( Adc_t *obj, uint32_t channel )
{
    ADC_ChannelConfTypeDef adcConf = { 0 };
    uint16_t adcData = 0;

    // Enable HSI
    __HAL_RCC_HSI_ENABLE( );

    // Wait till HSI is ready
    while( __HAL_RCC_GET_FLAG( RCC_FLAG_HSIRDY ) == RESET )
    {
    }

    __HAL_RCC_ADC1_CLK_ENABLE( );

    adcConf.Channel = channel;
    adcConf.Rank = ADC_RANK_CHANNEL_NUMBER;

    HAL_ADC_ConfigChannel( &AdcHandle, &adcConf );

    // Enable ADC1
    __HAL_ADC_ENABLE( &AdcHandle );

    // Start ADC Software Conversion
    HAL_ADC_Start( &AdcHandle );

    HAL_ADC_PollForConversion( &AdcHandle, HAL_MAX_DELAY );

    adcData = HAL_ADC_GetValue( &AdcHandle );

    __HAL_ADC_DISABLE( &AdcHandle );

    if( ( adcConf.Channel == ADC_CHANNEL_TEMPSENSOR ) || ( adcConf.Channel == ADC_CHANNEL_VREFINT ) )
    {
        HAL_ADC_DeInit( &AdcHandle );
    }
    __HAL_RCC_ADC1_CLK_DISABLE( );

    // Disable HSI
    __HAL_RCC_HSI_DISABLE( );

    return adcData;
}
