George-SK/Smart-Street-Lamp---LORa-Terminal/software/ACLight_LoRaMac_Node_20190226/src/apps/LoRaMac/classA/EmdoorNode/AC-Light/Commissioning.h

/*
 / _____)             _              | |
( (____  _____ ____ _| |_ _____  ____| |__
 \____ \| ___ |    (_   _) ___ |/ ___)  _ \
 _____) ) ____| | | || |_| ____( (___| | | |
(______/|_____)_|_|_| \__)_____)\____)_| |_|
    (C)2015 Semtech

Description: End device commissioning parameters

License: Revised BSD License, see LICENSE.TXT file include in the project

Maintainer: Miguel Luis and Gregory Cristian
*/
#ifndef __LORA_COMMISSIONING_H__
#define __LORA_COMMISSIONING_H__

/*!
 * When set to 1 the application uses the Over-the-Air activation procedure
 * When set to 0 the application uses the Personalization activation procedure
 */
#define OVER_THE_AIR_ACTIVATION                     1

/*!
 * Indicates if the end-device is to be connected to a private or public network
 */
#define LORAWAN_PUBLIC_NETWORK                      true

/*!
 * IEEE Organizationally Unique Identifier ( OUI ) (big endian)
 * \remark This is unique to a company or organization
 */
#define IEEE_OUI                                    0x55, 0x55, 0x55//0x00, 0x00, 0x00

/*!
 * Mote device IEEE EUI (big endian)
 *
 * \remark In this application the value is automatically generated by calling
 *         BoardGetUniqueId function
 */
#define LORAWAN_DEVICE_EUI                          { IEEE_OUI, 0x55, 0x55, 0x55, 0x55, 0x55 }//{ IEEE_OUI, 0x00, 0x00, 0x00, 0x00, 0x00 }

/*!
 * Application IEEE EUI (big endian)
 */
#define LORAWAN_APPLICATION_EUI                     {0x02, 0x7F, 0x00, 0x06, 0x00, 0x03, 0x00, 0x01}//{0x23, 0x23, 0x23, 0x23, 0x23, 0x23, 0x12, 0x35}//{0x00, 0x3F, 0x00, 0x03, 0x00, 0x01, 0x00, 0x01}//{0x23, 0x23, 0x23, 0x23, 0x23, 0x23, 0x12, 0x35}//{ 0x00, 0x00, 0x00, 0x00, 0x00, 0x00, 0x00, 0x00 }

/*!
 * AES encryption/decryption cipher application key
 */
#define LORAWAN_APPLICATION_KEY                     { 0x11, 0x12, 0x13, 0x14, 0x15, 0x16, 0x17, 0x18, 0x19, 0x1A, 0x1B, 0x1C, 0x1D, 0x1E, 0x1F, 0x13 }//{ 0x2B, 0x7E, 0x15, 0x16, 0x28, 0xAE, 0xD2, 0xA6, 0xAB, 0xF7, 0x15, 0x88, 0x09, 0xCF, 0x4F, 0x3C }

/*!
 * Current network ID
 */
#define LORAWAN_NETWORK_ID                          ( uint32_t )0x55555555//( uint32_t )0

/*!
 * Device address on the network (big endian)
 *
 * \remark In this application the value is automatically generated using
 *         a pseudo random generator seeded with a value derived from
 *         BoardUniqueId value if LORAWAN_DEVICE_ADDRESS is set to 0
 */
#define LORAWAN_DEVICE_ADDRESS                      ( uint32_t )0x52525252//( uint32_t )0x00000000

/*!
 * AES encryption/decryption cipher network session key
 */
#define LORAWAN_NWKSKEY                             { 0x2B, 0x7E, 0x15, 0x16, 0x28, 0xAE, 0xD2, 0xA6, 0xAB, 0xF7, 0x15, 0x88, 0x09, 0xCF, 0x4F, 0x3C }

/*!
 * AES encryption/decryption cipher application session key
 */
#define LORAWAN_APPSKEY                             { 0x2B, 0x7E, 0x15, 0x16, 0x28, 0xAE, 0xD2, 0xA6, 0xAB, 0xF7, 0x15, 0x88, 0x09, 0xCF, 0x4F, 0x3C }

#endif // __LORA_COMMISSIONING_H__
